lokianer/digivice/stl/back_clip_slider.stl

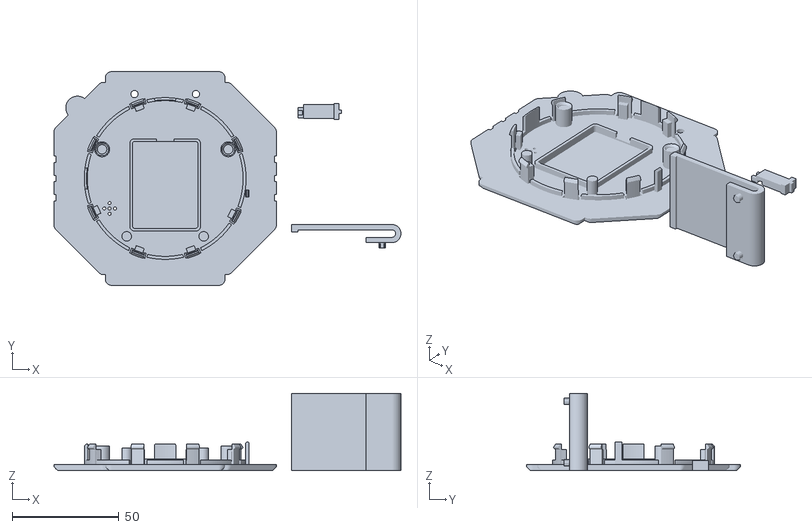
[picture p16: CAD file, 2026-09-27]
stl/back_clip_slider.stl
162.2 x 100.0 x 36.0
