lokianer/digivice/stl/single/clip.stl

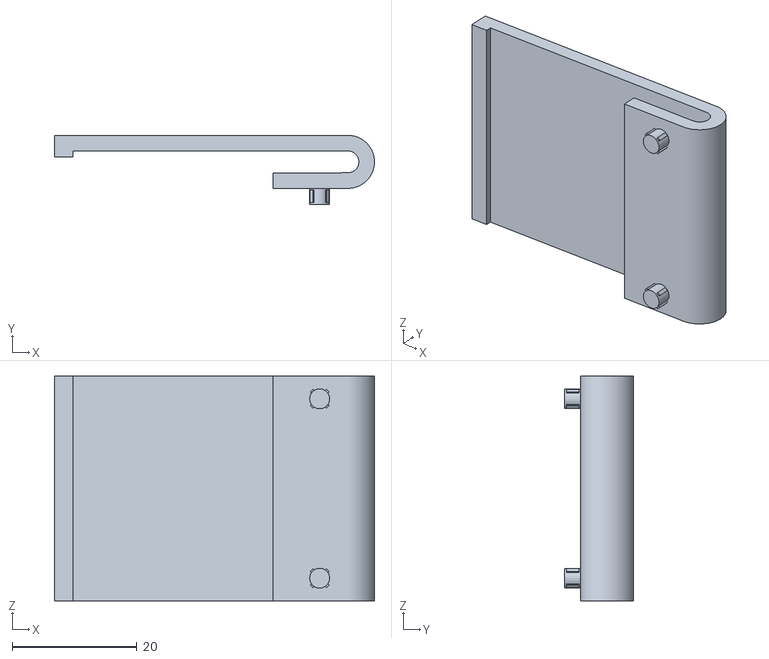
[picture p17: CAD file, 2026-09-27]
stl/single/clip.stl
51.2 x 11.1 x 36.0
