lokianer/digivice/stl/front_multicolor.stl

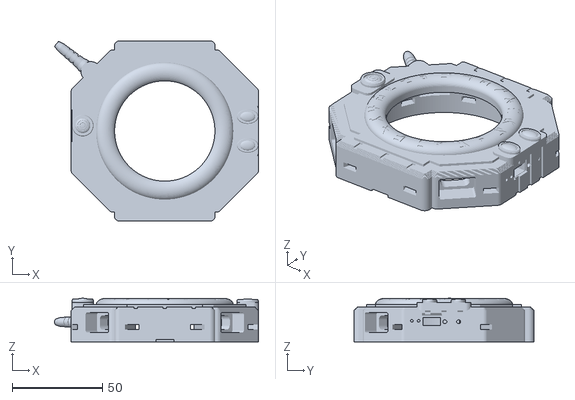
[picture p18: CAD file, 2026-09-27]
stl/front_multicolor.stl
113.2 x 100.0 x 24.2
