lokianer/digivice/stl/single/slider.stl

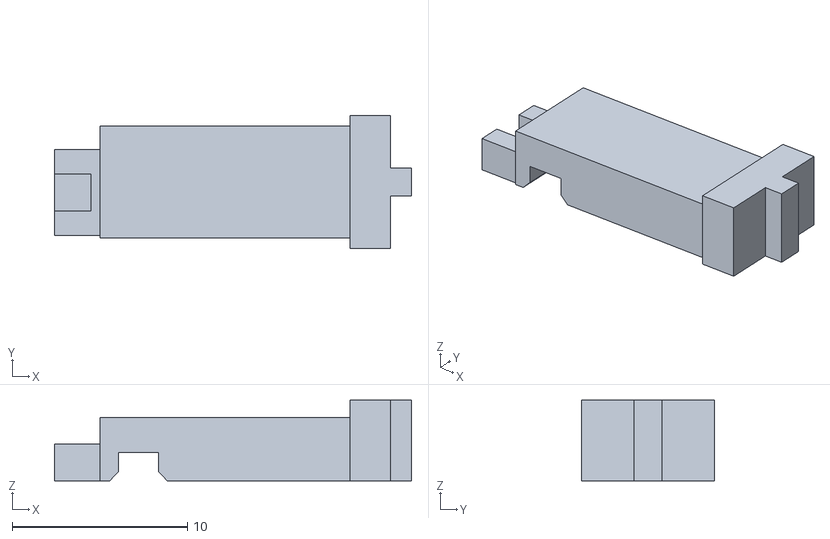
[picture p19: CAD file, 2026-09-27]
stl/single/slider.stl
20.4 x 7.60 x 4.60
