lokianer/digivice/stl/single/back.stl

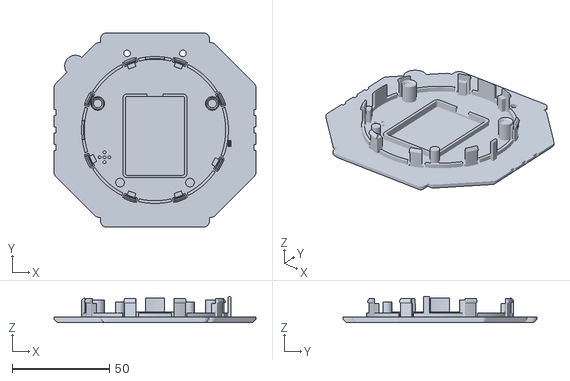
[picture p20: CAD file, 2026-09-27]
stl/single/back.stl
104.0 x 100.0 x 13.4
