lokianer/digivice/(list of files, cad)

Other CAD files:
stl/front_single_color.stl
