lokianer/digivice/(commit log)

2026-09-27 Digivice case v1.1: print files, Bambu P1S profiles, assembly guide, animations
    - STLs for both print plates (front multicolor/single color, back cover + clip + slider) and single parts
    - Bambu Studio profiles for the P1S 0.4 nozzle (front, back cover, PLA for the snap hooks)
    - Assembly guide and README in English and German
    - Reveal and assembly animations (GIF/MP4) and the 90-second film
    - CC BY-NC-SA 4.0
    [back.stl, back_clip_slider.stl, clip.stl, front_multicolor.stl, front_single_color.stl, slider.stl]
2026-09-27 Digivice case v1.2: print files, profiles, guide and images
    - Clip pegs end inside the back cover (v1.1 pegs hit the front wall, the lid could not close); full-width clip arm prints on the bed
    - Snap hooks redesigned for PLA: root pockets, tapered beams, root fillets, round barbs, 35° lead-in, 0.7 mm undercut, over-travel stops
    - Centering guides, cavity chamfer, cups on the upper pillars stop the board from rotating
    - Slider knob stops at the recess floor, chamfered post and groove
    - No supports in the snap windows, slider tunnel or on the flanks; plate 2 needs no supports
    - Profiles: back cover 100 % infill, front supports style Snug
    - Assembly guide in the new order, English and German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
    [back.stl, back_clip_slider.stl, clip.stl, front_multicolor.stl, front_single_color.stl, slider.stl]
